NoboruFox/car_dimmer/car_dimmer/BOM_For_CD.xlsx

source3 | number4 | value | ref | value5 | footprint | datasheet | field | name6 | lib | part | description | names | tstamps7
 |  |  | D2 | 1N4148W | Diode_SMD:D_SOD-123 | https://www.vishay.com/docs/85748/1n4148w.pdf | https://www.chipdip.ru/product/mmsd4148 - 200мА (https://www.chipdip.ru/product/mmsd4148%20-%20200мА) | Альтернатива | Diode | 1N4148W | 75V 0.15A Fast Switching Diode, SOD-123 | / | /
 |  |  | D2 | 1N4148W | Diode_SMD:D_SOD-123 | https://www.vishay.com/docs/85748/1n4148w.pdf | https://www.chipdip.ru/product/1n4148w-5 | ЧиД | Diode | 1N4148W | 75V 0.15A Fast Switching Diode, SOD-123 | / | /
 | 1 уже есть | 2040 | U1 | PC 123 | Package_DIP:DIP-4_W7.62mm |  | https://www.chipdip.ru/product/pc123 | ЧиД | Isolator | SFH617A-1 | Optocoupler, Phototransistor Output, 5300 VRMS, VCEO 70V, CTR% 40-80, -55 to +110 degree Celcius, UL, BSI, FIMKO, cUL, THT PDIP-4 | / | /
 | 1 (20) | 9000079902 | R1 | 300 | Resistor_SMD:R_1206_3216Metric_Pad1.42x1.75mm_HandSolder | ~ | https://www.chipdip.ru/product0/9000079902 | ЧиД | Device | R | Resistor | / | /
 | 1 (20) | 9000079659 | R2 | 10K | Resistor_SMD:R_1206_3216Metric_Pad1.42x1.75mm_HandSolder | ~ | https://www.chipdip.ru/product0/9000079659 | ЧиД | Device | R | Resistor | / | /
 | 1 (20) есть уже | 9000079691 | R3 | 56K | Resistor_SMD:R_1206_3216Metric_Pad1.42x1.75mm_HandSolder | ~ | https://www.chipdip.ru/product0/9000079691 | ЧиД | Device | R | Resistor | / | /
 | 1 | 6916665003 | D1 | BZX84Cxx | Diode_SMD:D_SOT-23_ANK | https://diotec.com/tl_files/diotec/files/pdf/datasheets/bzx84c2v4.pdf | https://www.chipdip.ru/product/bzx84c13 | ЧиД | Diode | BZX84Cxx | 300mW Zener Diode, SOT-23 | / | /
 |  |  | J1 | Conn_01x04_Male | Connector_JST:JST_VH_B4PS-VH_1x04_P3.96mm_Horizontal | ~ | https://www.chipdip.ru/product/pwl-4r - 3.96 (https://www.chipdip.ru/product/pwl-4r%20-%203.96) | Альтернатива | Connector | Conn_01x04_Male | Generic connector, single row, 01x04, script generated (kicad-library-utils/schlib/autogen/connector/) | / | /
 | 1 | 59183 | J1 | Conn_01x04_Male | Connector_JST:JST_VH_B4PS-VH_1x04_P3.96mm_Horizontal | ~ | https://www.chipdip.ru/product/pwl-4r - 3.96 (https://www.chipdip.ru/product/pwl-4r%20-%203.96) | ЧиД | Connector | Conn_01x04_Male | Generic connector, single row, 01x04, script generated (kicad-library-utils/schlib/autogen/connector/) | / | /
 |  |  | Q1 | IRF95305Spbf | Package_TO_SOT_SMD:TO-263-2 |  | https://www.chipdip.ru/product/irf9540nspbf - 140W | Альтернатива | Transistor_FET | IRF9540N | -23A Id, -100V Vds, HEXFET P-Channel MOSFET, TO-220 | / | /
 | 1 | 9000013154 | Q1 | IRF95305Spbf | Package_TO_SOT_SMD:TO-263-2 |  | https://www.chipdip.ru/product/irf5305spbf | ЧиД | Transistor_FET | IRF9540N | -23A Id, -100V Vds, HEXFET P-Channel MOSFET, TO-220 | / | /
поставленный не подойдет - от 104шт | 1 (10) | 9000141173 | C1 | 10u | Resistor_SMD:R_1210_3225Metric_Pad1.42x2.65mm_HandSolder | ~ | https://www.chipdip.ru/product/grm32er6ya106ka12l - ceramic | ЧиД | Device | CP | Polarized capacitor | / | /
 | 1 (20) | 690816980 | R4 | 1M | Resistor_SMD:R_1206_3216Metric_Pad1.42x1.75mm_HandSolder | ~ | https://www.chipdip.ru/product0/690816980 | ЧиД | Device | R | Resistor | / | /
 |  |  | D3 | 1N4148W | Diode_SMD:D_SOD-123 | https://www.vishay.com/docs/85748/1n4148w.pdf | https://www.chipdip.ru/product/mmsd4148 - 200мА (https://www.chipdip.ru/product/mmsd4148%20-%20200мА) | Альтернатива | Diode | 1N4148W | 75V 0.15A Fast Switching Diode, SOD-123 | / | /
 | 2 | 9000461666 | D3 | 1N4148W | Diode_SMD:D_SOD-123 | https://www.vishay.com/docs/85748/1n4148w.pdf | https://www.chipdip.ru/product/1n4148w-5 | ЧиД | Diode | 1N4148W | 75V 0.15A Fast Switching Diode, SOD-123 | / | /
 | 1 | 51178 |  |  | PHU- 4 (DS1072-4 F), Розетка каб.с конт. 3.96мм |  | https://www.chipdip.ru/product/phu-4
