NoboruFox/car_dimmer/car_dimmer/car_dimmer.kicad_pcb

## KiCad design car_dimmer/car_dimmer.kicad_pcb (2019-11-30)

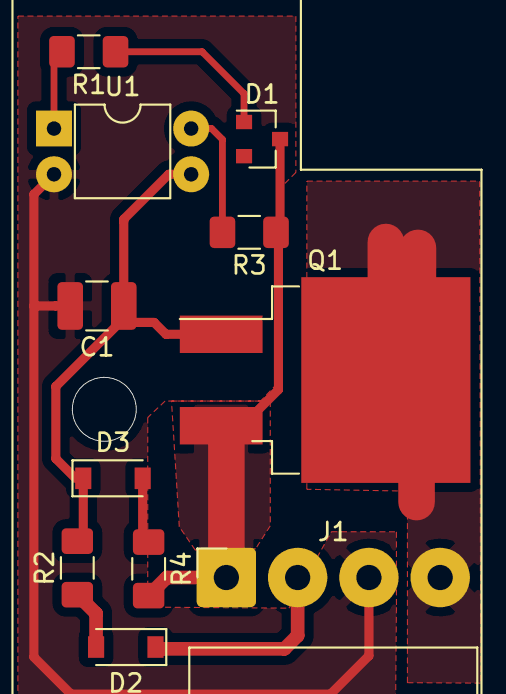
[picture p3: board car_dimmer.kicad_pcb from above]

Board: 2 copper layers, 11 parts (0 on the bottom side), 10 nets.

Parts:
C1: 10u; R_1210_3225Metric_Pad1.42x2.65mm_HandSolder
D1: BZX84Cxx; D_SOT-23_ANK
D2, D3: 1N4148W; D_SOD-123
J1: Conn_01x04_Male; JST_VH_B4PS-VH_1x04_P3.96mm_Horizontal
Q1: IRF95305Spbf; TO-263-2
R1: 300; R_1206_3216Metric_Pad1.42x1.75mm_HandSolder
R2: 10K; R_1206_3216Metric_Pad1.42x1.75mm_HandSolder
R3: 56K; R_1206_3216Metric_Pad1.42x1.75mm_HandSolder
R4: 1M; R_1206_3216Metric_Pad1.42x1.75mm_HandSolder
U1: PC 123; DIP-4_W7.62mm

Connections:
+12V: D1.1, J1.1, Q1.3, R3.1, R4.2
DOOR: D2.1, J1.2
GND: C1.2, J1.3, U1.2
unnamed: C1.1, D3.1, Q1.1, R2.2, U1.3
unnamed: D1.2, R1.1
unnamed: D2.2, R2.1
unnamed: D3.2, R4.1
unnamed: R1.2, U1.1
unnamed: R3.2, U1.4
OUT: J1.4, Q1.2
