NoboruFox/car_dimmer/(commit log)

2019-11-28 [WIP] created a car dimmer project
    [car_dimmer.kicad_pcb, car_dimmer.sch]
2019-11-29 [WIP]: Sch is drawn, need to finish and make pcb
    [car_dimmer.sch]
2019-11-30 [WIP]: Schematic is done, PCB is routed and ready to final check
    [BOM_For_CD.xlsx, car_dimmer.kicad_pcb, car_dimmer.sch]
2019-12-01 [FEAT]: Finally checked
    [car_dimmer.sch]
2019-12-06 [FEAT]: added a docs file with description of schematic
